GustavoVieira13/Smart-Collar-for-Donkey-Breeds/gateway installation.jpg

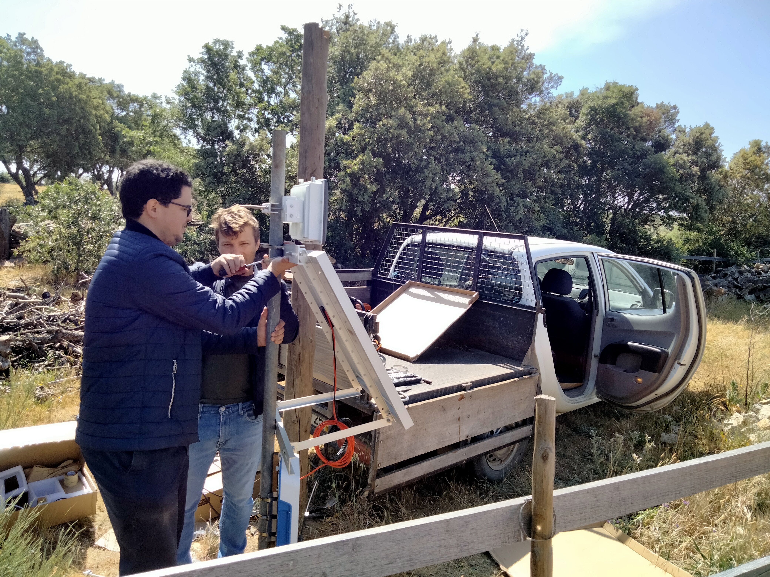
gateway installation.jpg
