GustavoVieira13/Smart-Collar-for-Donkey-Breeds/gateway installed.jpg

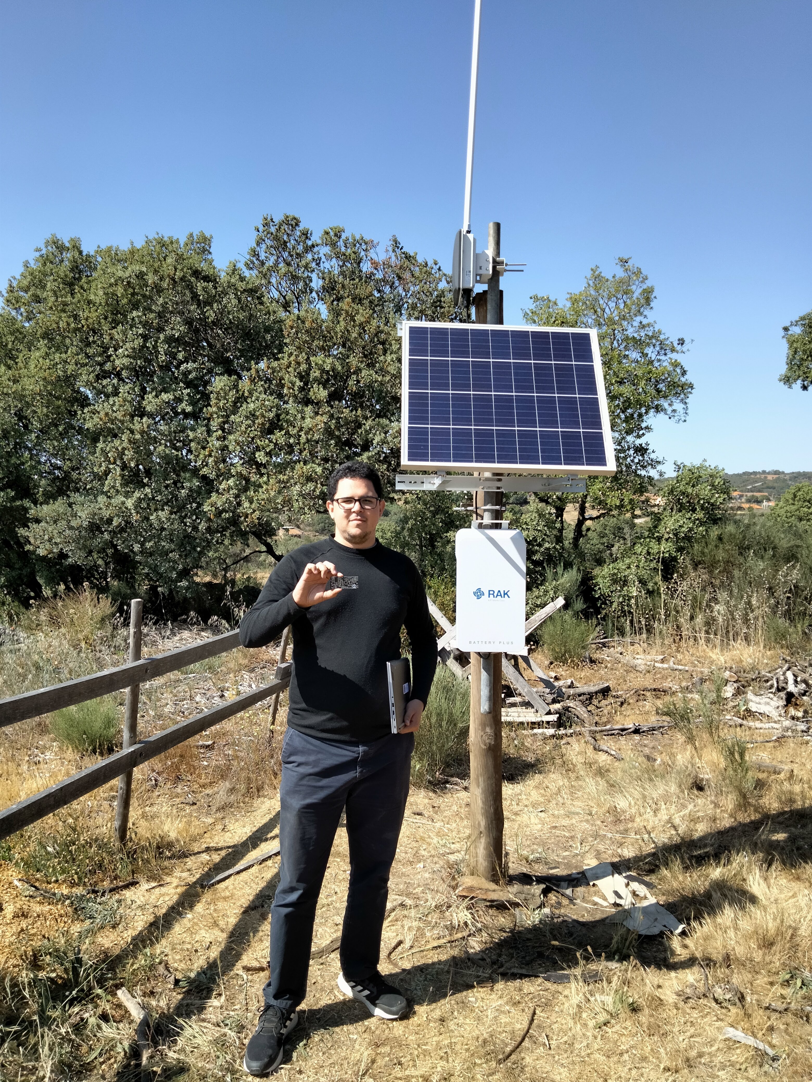
gateway installed.jpg
