GustavoVieira13/Smart-Collar-for-Donkey-Breeds/README.md

# Smart-Collar-for-Donkey-Breeds
Smart Collar for Donkey Breeds embedding sensors that track humidity, air temperature, air pressure, orientation and acceleration. Communicating through LoRaWAN.
