GustavoVieira13/Smart-Collar-for-Donkey-Breeds/AEPGA.jpg

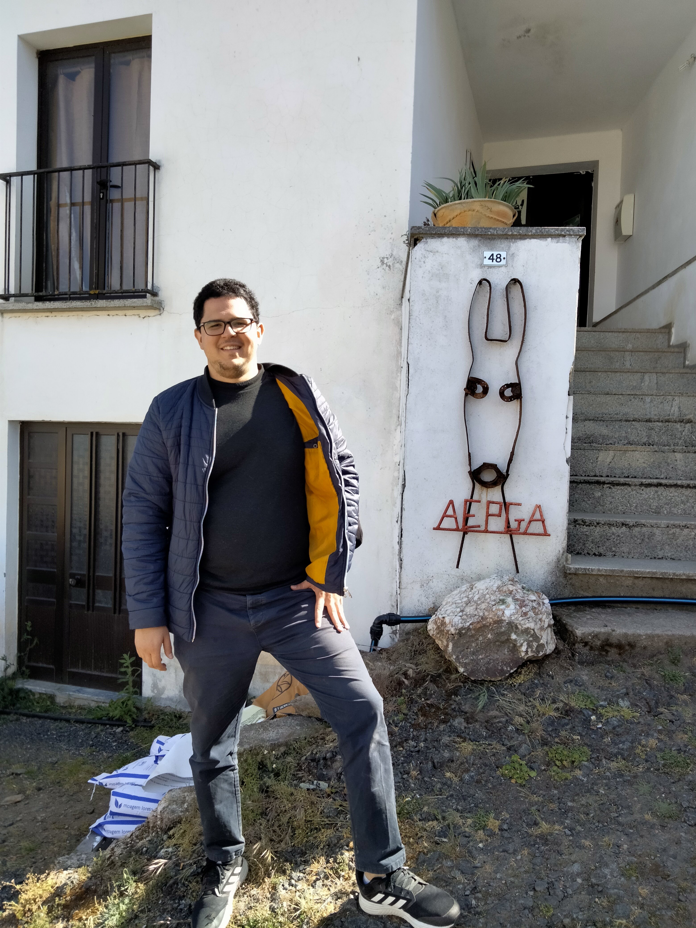
AEPGA.jpg
