GustavoVieira13/Smart-Collar-for-Donkey-Breeds/asininos AEPGA 1.png

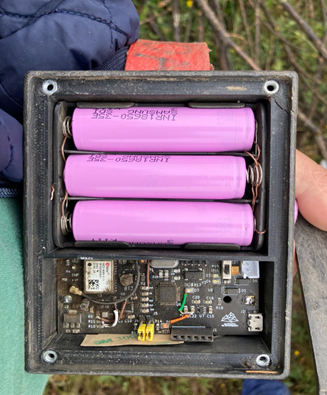
asininos AEPGA 1.png
