GustavoVieira13/Smart-Collar-for-Donkey-Breeds/asininos AEPGA 2.png

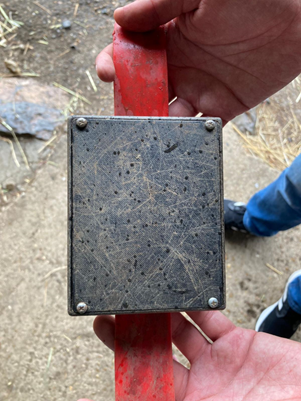
asininos AEPGA 2.png
