GustavoVieira13/Smart-Collar-for-Donkey-Breeds/asininos AEPGA 3.png

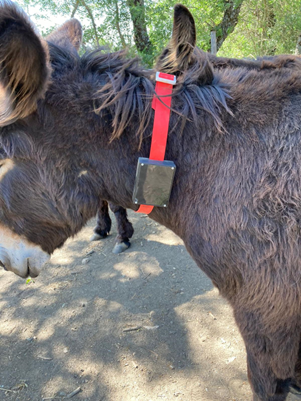
asininos AEPGA 3.png
