GustavoVieira13/Smart-Collar-for-Donkey-Breeds/happy moment.jpg

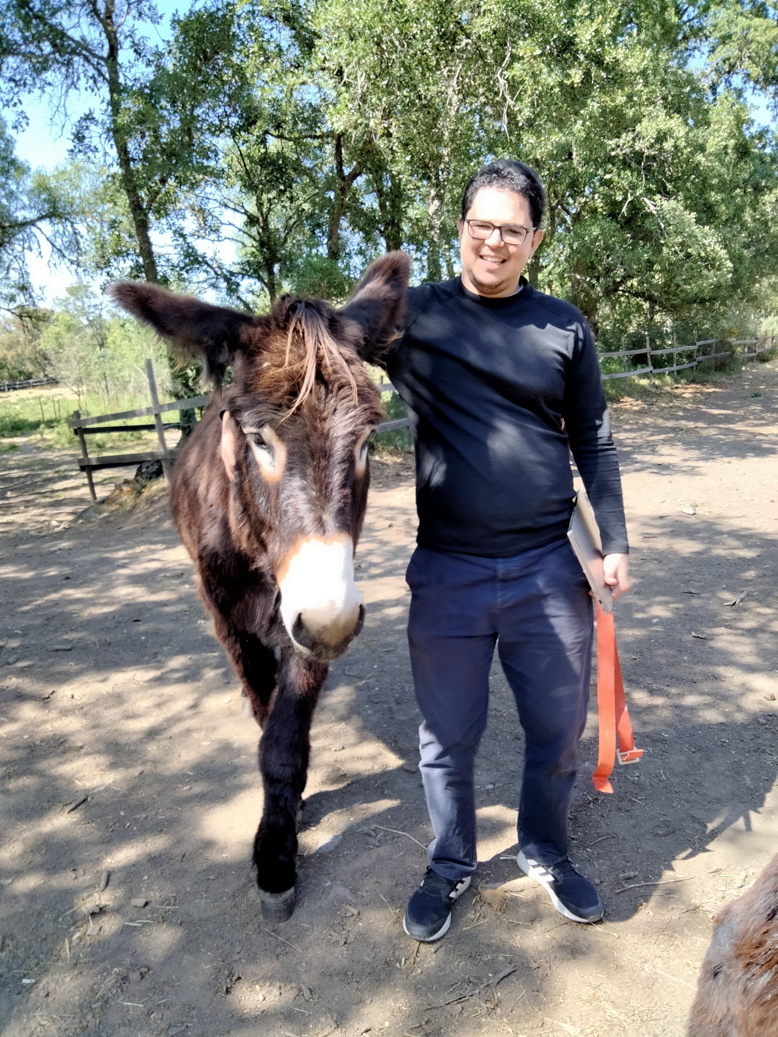
happy moment.jpg
