GustavoVieira13/Smart-Collar-for-Donkey-Breeds/PCB asininos.jpg

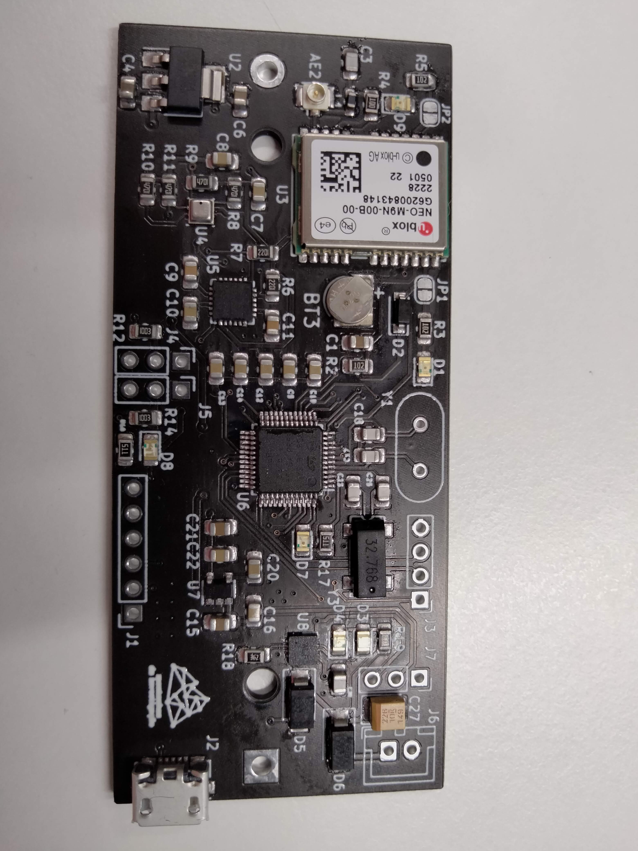
PCB asininos.jpg
