GustavoVieira13/Smart-Collar-for-Donkey-Breeds/successful connection.jpg

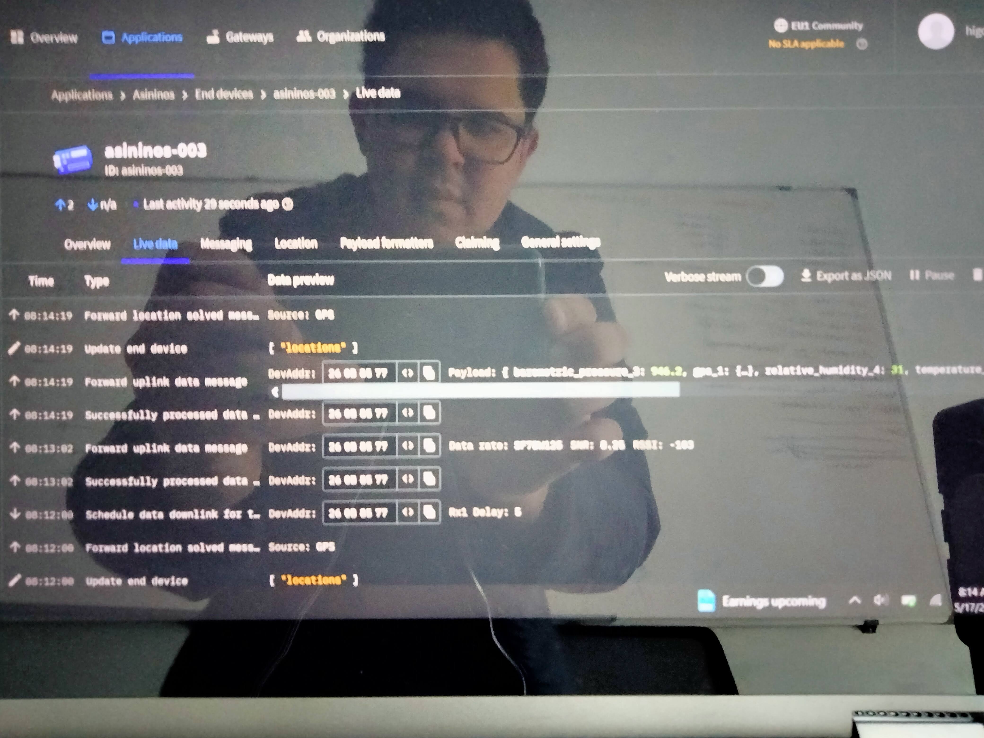
successful connection.jpg
