GustavoVieira13/Smart-Collar-for-Donkey-Breeds/schematic_asininos.pdf

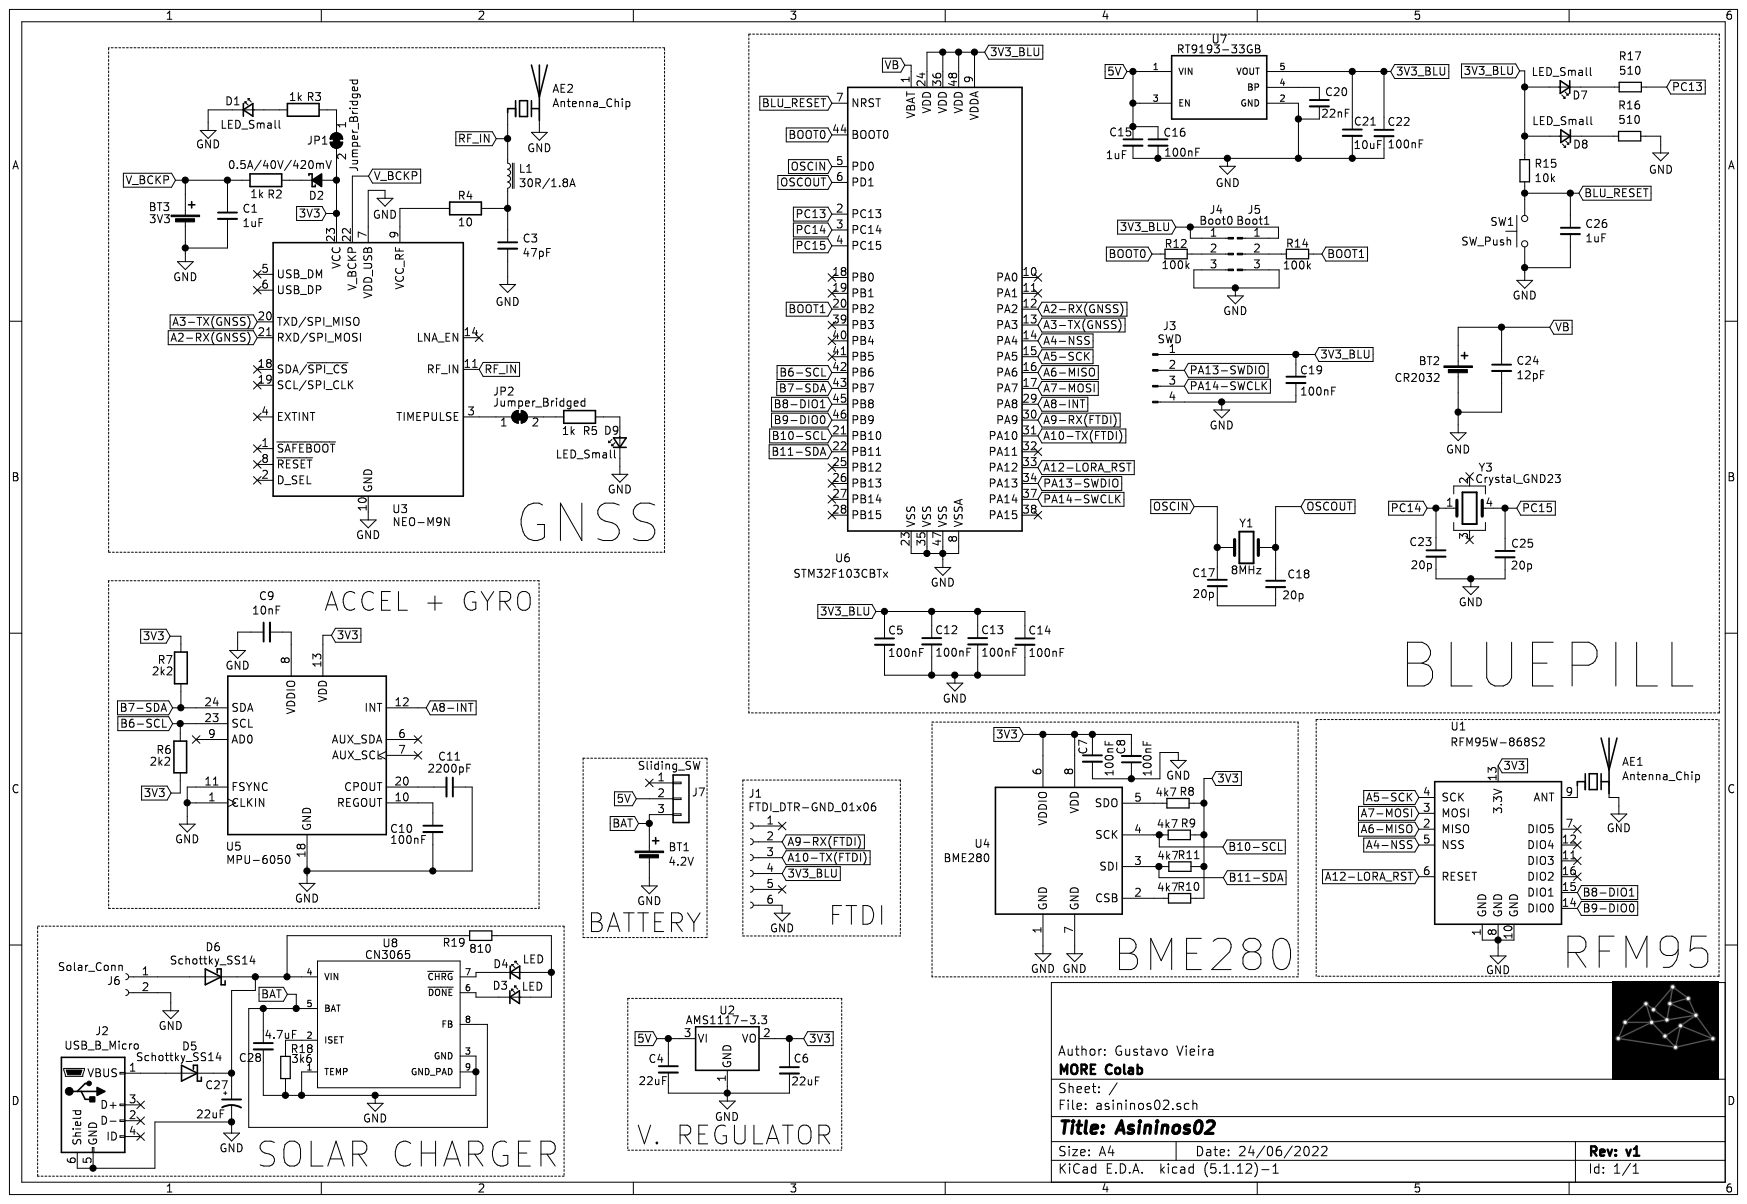
[picture p10: page 1]
