GustavoVieira13/Smart-Collar-for-Donkey-Breeds/asininos02.kicad_pcb

## KiCad design asininos02.kicad_pcb (2026-08-10)

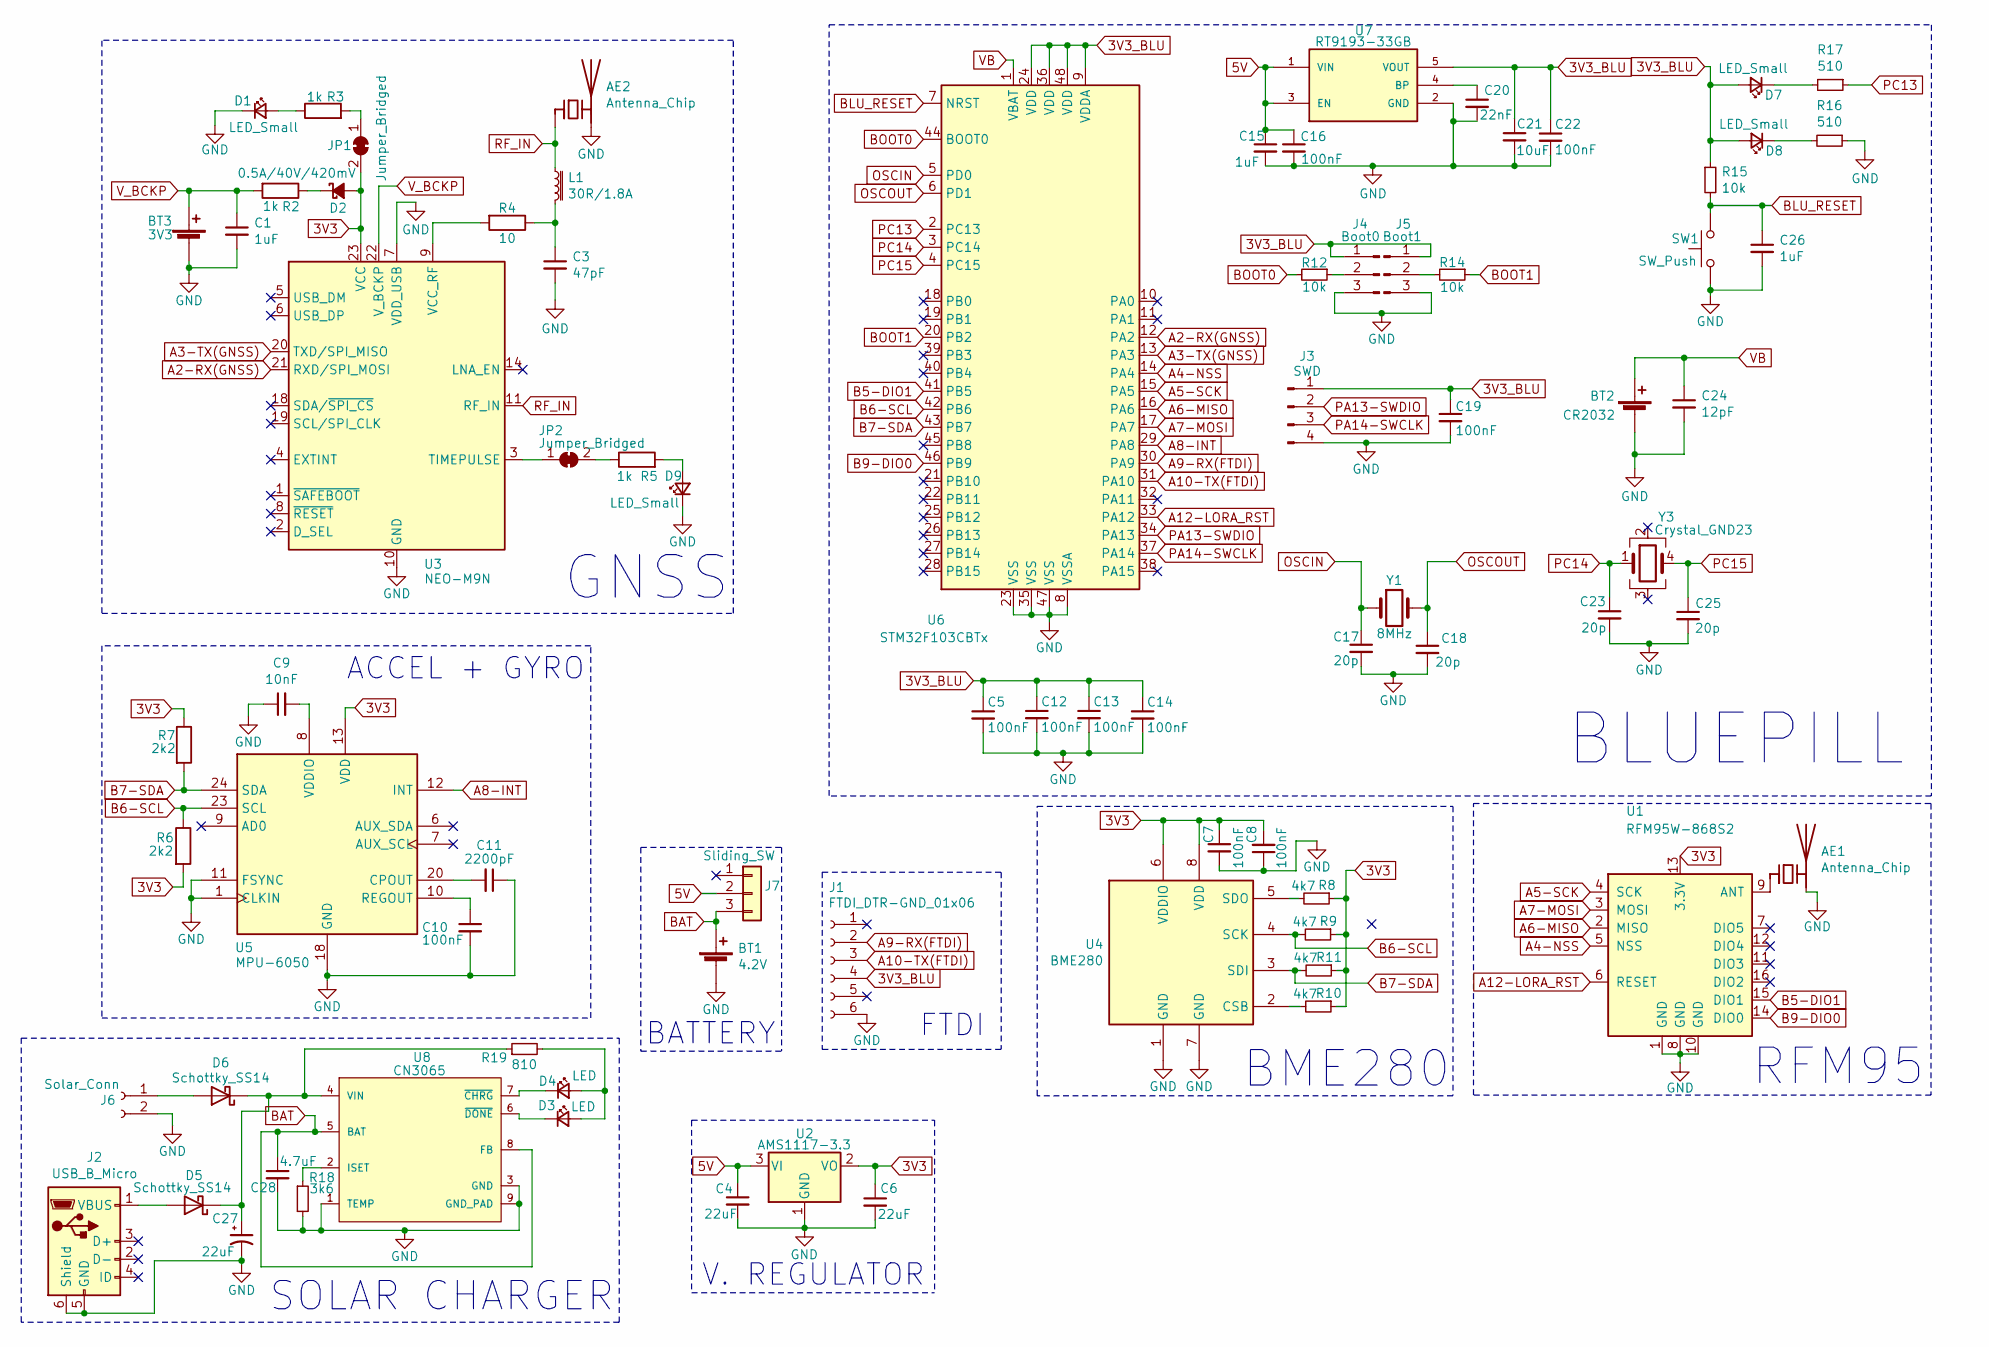
[picture p11: schematic asininos02.sch]

Parts:
AE1, AE2: Antenna_Chip; U.FL_Hirose_U.FL-R-SMT-1_Vertical
BT1: 4.2V; BatteryHolder_MPD_BH-18650-PC2
BT2: CR2032; BatteryHolder_Keystone_1058_1x2032
BT3: 3V3; SEIKO_ML414H_IV01E
C1, C15, C26: 1uF; C_0805_2012Metric_Pad1.18x1.45mm_HandSolder
C3: 47pF; C_0805_2012Metric_Pad1.18x1.45mm_HandSolder
C4, C6: 22uF; C_0805_2012Metric_Pad1.18x1.45mm_HandSolder
C5, C7, C8, C10, C12, C13, C14, C16, C19, C22: 100nF; C_0805_2012Metric_Pad1.18x1.45mm_HandSolder
C9: 10nF; C_0805_2012Metric_Pad1.18x1.45mm_HandSolder
C11: 2200pF; C_0805_2012Metric_Pad1.18x1.45mm_HandSolder
C17, C18, C23, C25: 20p; C_0805_2012Metric_Pad1.18x1.45mm_HandSolder
C20: 22nF; C_0805_2012Metric_Pad1.18x1.45mm_HandSolder
C21: 10uF; C_0805_2012Metric_Pad1.18x1.45mm_HandSolder
C24: 12pF; C_0805_2012Metric_Pad1.18x1.45mm_HandSolder
C27: 22uF; CP_EIA-3528-21_Kemet-B
C28: 4.7uF; C_0805_2012Metric_Pad1.18x1.45mm_HandSolder
D1, D7, D8, D9: LED_Small; LED_0805_2012Metric_Pad1.15x1.40mm_HandSolder
D2: 0.5A/40V/420mV; D_SOD-123
D3, D4: LED; LED_0805_2012Metric_Pad1.15x1.40mm_HandSolder
D5, D6: Schottky_SS14; D_SMA
J1: FTDI_DTR-GND_01x06; PinSocket_1x06_P2.54mm_Vertical
J2: USB_B_Micro; USB_Micro-B_Molex_47346-0001
J3: SWD; PinHeader_1x04_P2.54mm_Vertical
J4: Boot0; PinHeader_1x03_P2.54mm_Vertical
J5: Boot1; PinHeader_1x03_P2.54mm_Vertical
J6: Solar_Conn; JST_XH_B2B-XH-A_1x02_P2.50mm_Vertical
J7: Sliding_SW; PinSocket_1x03_P2.54mm_Vertical
JP1, JP2: Jumper_Bridged; SolderJumper-2_P1.3mm_Bridged_RoundedPad1.0x1.5mm
L1: 30R/1.8A; L_0603_1608Metric_Pad1.05x0.95mm_HandSolder
R2, R3, R5: 1k; R_0805_2012Metric_Pad1.20x1.40mm_HandSolder
R4: 10; R_0805_2012Metric_Pad1.20x1.40mm_HandSolder
R6, R7: 2k2; R_0805_2012Metric_Pad1.20x1.40mm_HandSolder
R8, R9, R10, R11: 4k7; R_0805_2012Metric_Pad1.20x1.40mm_HandSolder
R12, R14, R15: 10k; R_0805_2012Metric_Pad1.20x1.40mm_HandSolder
R16, R17: 510; R_0805_2012Metric_Pad1.20x1.40mm_HandSolder
R18: 3k6; R_0805_2012Metric_Pad1.20x1.40mm_HandSolder
R19: 810; R_0805_2012Metric_Pad1.20x1.40mm_HandSolder
SW1: SW_Push; SW_SPST_CK_RS282G05A3
U1: RFM95W-868S2; HOPERF_RFM9XW_SMD
U2: AMS1117-3.3; SOT-223-3_TabPin2
U3: NEO-M9N; ublox_NEO
U4: BME280; Bosch_LGA-8_2.5x2.5mm_P0.65mm_ClockwisePinNumbering
U5: MPU-6050; InvenSense_QFN-24_4x4mm_P0.5mm_NoMask
U6: STM32F103CBTx; LQFP-48_7x7mm_P0.5mm
U7: RT9193-33GB; SOT-23-5
U8: CN3065; DFN-8-1EP_3x3mm_P0.5mm_EP1.66x2.38mm; voltage 6V
Y1: 8MHz; Crystal_HC49-4H_Vertical
Y3: Crystal_GND23; Crystal_SMD_SeikoEpson_MC306-4Pin_8.0x3.2mm

Connections:
3V3: C6.1, C7.1, C8.2, D2.2 (A), JP1.2 (B), R6.2, R7.1, R8.1, R9.1, R10.1, R11.1, U1.13 (3.3V), U2.2 (VO), U3.23 (VCC), U4.6 (VDDIO), U4.8 (VDD), U5.13 (VDD)
3V3_BLU: C5.1, C12.1, C13.1, C14.1, C19.1, C21.1, C22.1, D7.2 (A), D8.2 (A), J1.4, J3.1, J4.1, J5.1, R15.1, U6.9 (VDDA), U6.24 (VDD), U6.36 (VDD), U6.48 (VDD), U7.5 (VOUT)
5V: C4.1, C15.1, C16.1, J7.2, U2.3 (VI), U7.1 (VIN), U7.3 (EN)
A2-RX(GNSS): U3.21 (RXD/SPI_MOSI), U6.12 (PA2)
A3-TX(GNSS): U3.20 (TXD/SPI_MISO), U6.13 (PA3)
A4-NSS: U1.5 (NSS), U6.14 (PA4)
A5-SCK: U1.4 (SCK), U6.15 (PA5)
A6-MISO: U1.2 (MISO), U6.16 (PA6)
A7-MOSI: U1.3 (MOSI), U6.17 (PA7)
A8-INT: U5.12 (INT), U6.29 (PA8)
A9-RX(FTDI): J1.2, U6.30 (PA9)
A10-TX(FTDI): J1.3, U6.31 (PA10)
A12-LORA_RST: U1.6 (RESET), U6.33 (PA12)
B5-DIO1: U1.15 (DIO1), U6.41 (PB5)
B6-SCL: R6.1, R9.2, U4.4 (SCK), U5.23 (SCL), U6.42 (PB6)
B7-SDA: R7.2, R11.2, U4.3 (SDI), U5.24 (SDA), U6.43 (PB7)
B9-DIO0: U1.14 (DIO0), U6.46 (PB9)
BAT: BT1.1 (+), C28.1, J7.3, U8.5 (BAT), U8.8 (FB)
BLU_RESET: C26.1, R15.2, SW1.2, U6.7 (NRST)
BOOT0: R12.2, U6.44 (BOOT0)
BOOT1: R14.1, U6.20 (PB2)
GND: AE1.2 (PCB_Trace), AE2.2 (PCB_Trace), BT1.2 (-), BT2.2 (-), BT3.2 (-), C1.2, C3.2, C4.2, C5.2, C6.2, C7.2, C8.1, C9.1, C10.2, C11.1, C12.2, C13.2, C14.2, C15.2, C16.2, C17.2, C18.2, C19.2, C20.2, C21.2, C22.2, C23.2, C24.2, C25.2, C26.2, C27.2, C28.2, D1.1 (K), D9.1 (K), J1.6, J2.5 (GND), J2.6 (Shield), J3.4, J4.3, J5.3, J6.2, R16.1, R18.2, SW1.1, U1.1 (GND), U1.8 (GND), U1.10 (GND), U2.1 (GND), U3.7 (VDD_USB), U3.10 (GND), U3.12 (GND), U3.13 (GND), U3.24 (GND), U4.1 (GND), U4.7 (GND), U5.1 (CLKIN), U5.11 (FSYNC), U5.18 (GND), U6.8 (VSSA), U6.23 (VSS), U6.35 (VSS), U6.47 (VSS), U7.2 (GND), U8.1 (TEMP), U8.3 (GND), U8.9 (GND_PAD)
unnamed: AE1.1 (FEED), U1.9 (ANT)
unnamed: C3.1, L1.2, R4.1
unnamed: C9.2, U5.8 (VDDIO)
unnamed: C10.1, U5.10 (REGOUT)
unnamed: C11.2, U5.20 (CPOUT)
unnamed: C20.1, U7.4 (BP)
unnamed: C27.1, D5.1 (K), D6.1 (K), R19.1, U8.4 (VIN)
unnamed: D1.2 (A), R3.1
unnamed: D2.1 (K), R2.1
unnamed: D3.1 (K), U8.6 (~DONE~)
unnamed: D3.2 (A), D4.2 (A), R19.2
unnamed: D4.1 (K), U8.7 (~CHRG~)
unnamed: D5.2 (A), J2.1 (VBUS)
unnamed: D6.2 (A), J6.1
unnamed: D7.1 (K), R17.2
unnamed: D8.1 (K), R16.2
unnamed: D9.2 (A), R5.2
unnamed: J4.2, R12.1
unnamed: J5.2, R14.2
unnamed: JP1.1 (A), R3.2
unnamed: JP2.1 (A), U3.3 (TIMEPULSE)
unnamed: JP2.2 (B), R5.1
unnamed: R4.2, U3.9 (VCC_RF)
unnamed: R8.2, U4.5 (SDO)
unnamed: R10.2, U4.2 (CSB)
unnamed: R18.1, U8.2 (ISET)
OSCIN: C17.1, U6.5 (PD0), Y1.1
OSCOUT: C18.1, U6.6 (PD1), Y1.2
PA13-SWDIO: J3.2, U6.34 (PA13)
PA14-SWCLK: J3.3, U6.37 (PA14)
PC13: R17.1, U6.2 (PC13)
PC14: C23.1, U6.3 (PC14), Y3.1
PC15: C25.1, U6.4 (PC15), Y3.4
RF_IN: AE2.1 (FEED), L1.1, U3.11 (RF_IN)
VB: BT2.1 (+), C24.1, U6.1 (VBAT)
V_BCKP: BT3.1 (+), C1.1, R2.2, U3.22 (V_BCKP)

Notes on the sheet:
BLUEPILL
RFM95
BME280
GNSS
V. REGULATOR
FTDI
ACCEL + GYRO
BATTERY
SOLAR CHARGER

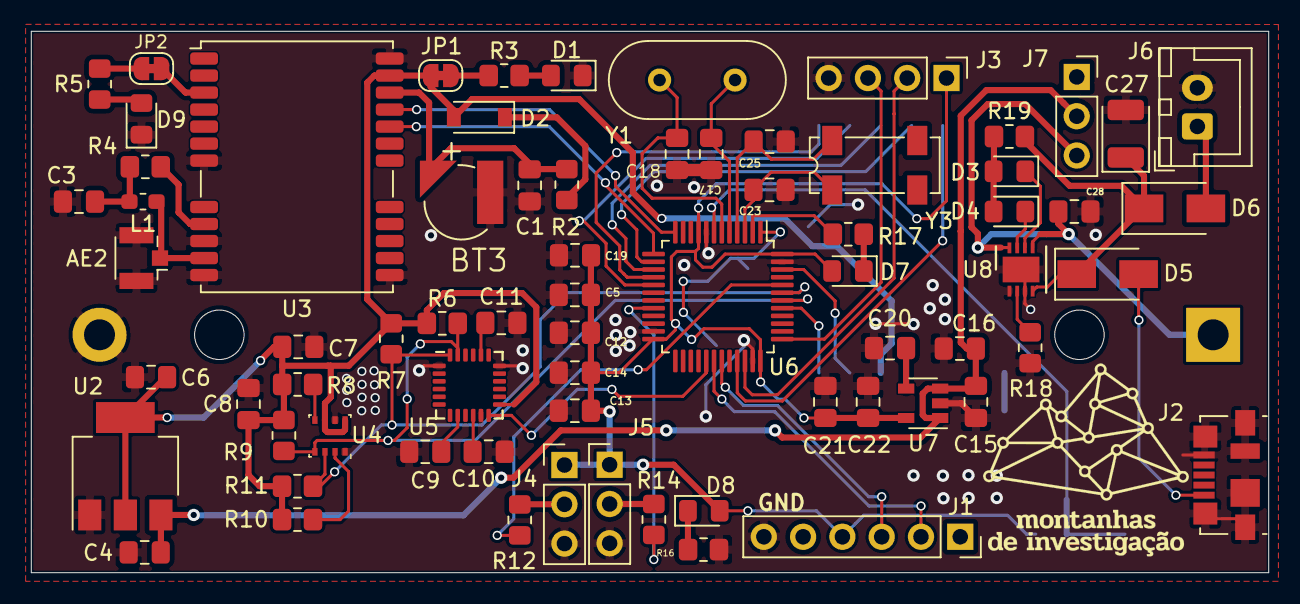
[picture p12: board asininos02.kicad_pcb from above]

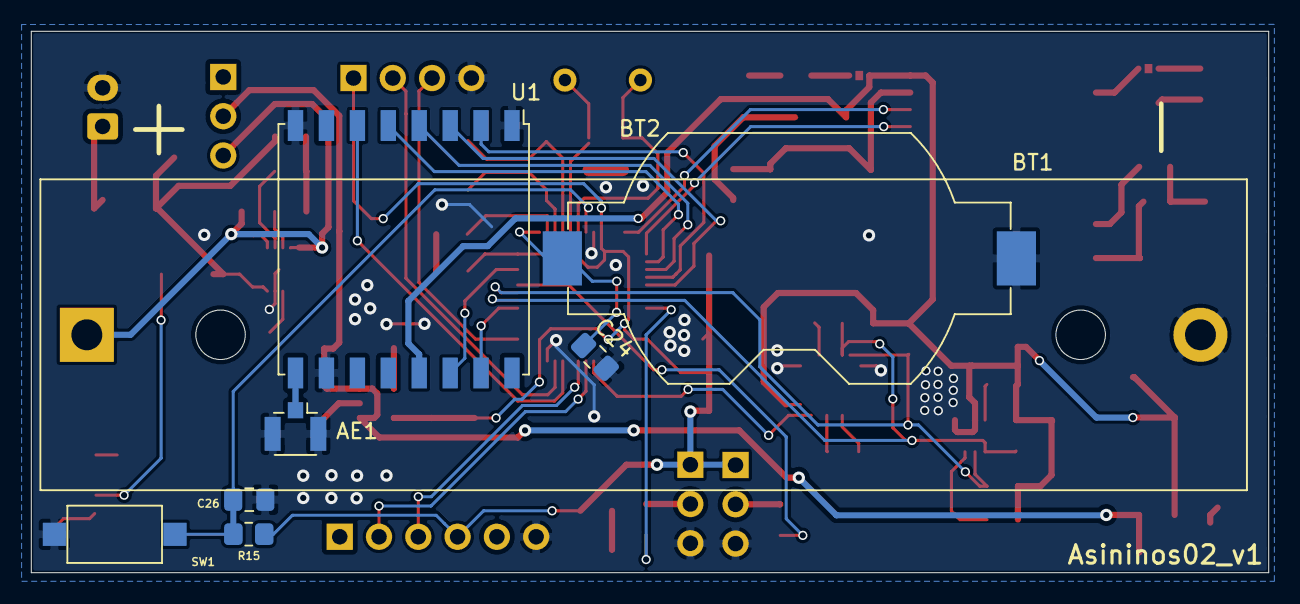
[picture p13: board asininos02.kicad_pcb from below]

Board: 2 copper layers, 80.0 x 35.0 mm, 79 parts (8 on the bottom side), 58 nets.
